casainho/EBike-Smart-Controller/hardware/EBike_Smart_Controller-600x.jpg

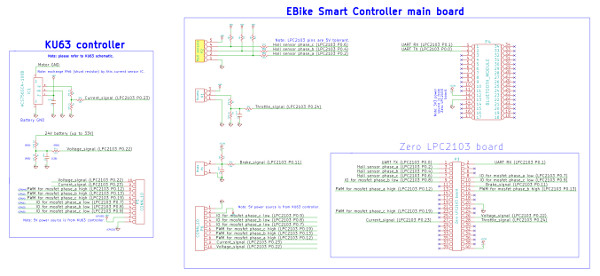
hardware/EBike_Smart_Controller-600x.jpg
