casainho/EBike-Smart-Controller/README.md

EBike-Smart-Controller
======================

EBike Smart Controller
