casainho/EBike-Smart-Controller/hardware/EBike_Smart_Controller-prototype_v2.png

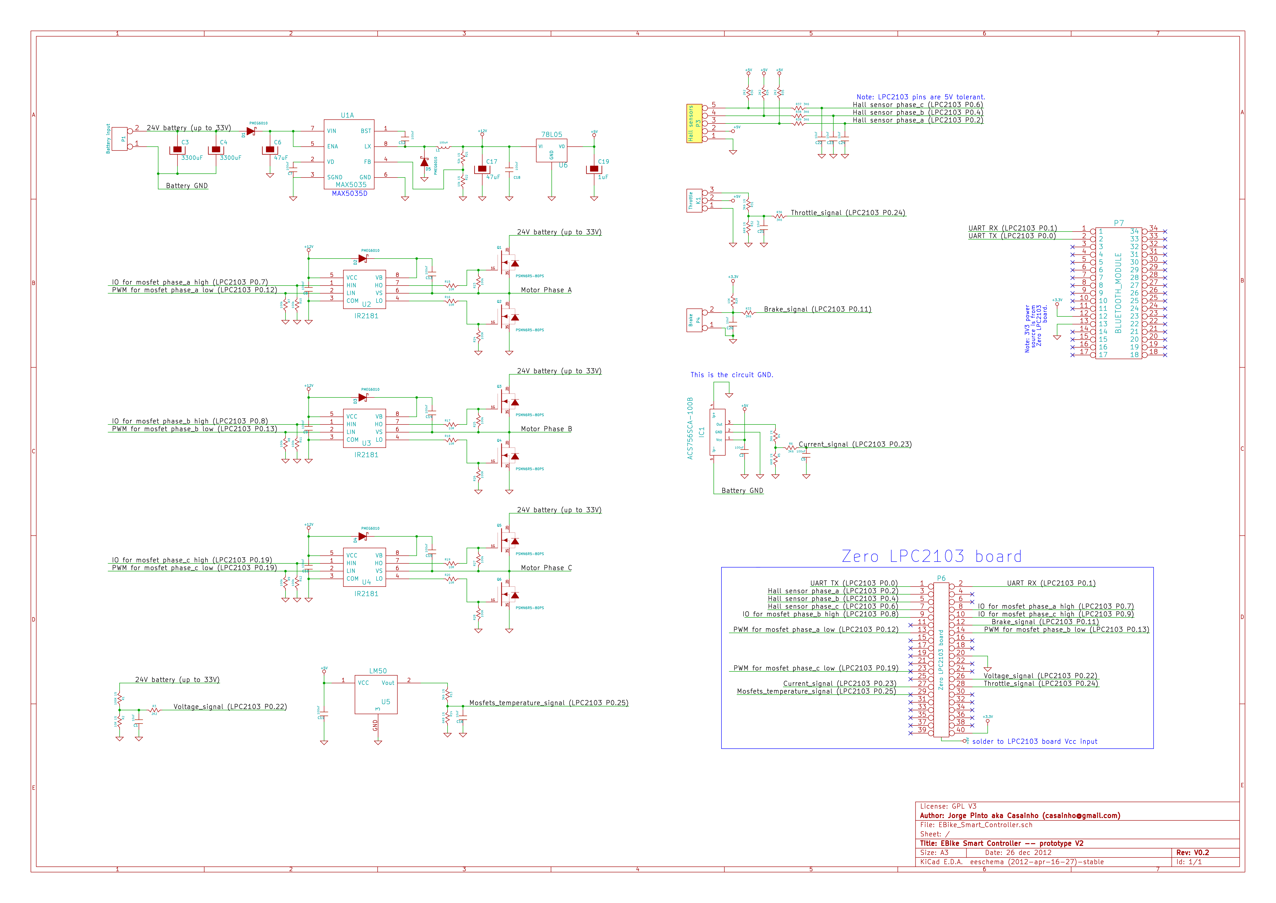
hardware/EBike_Smart_Controller-prototype_v2.png
