casainho/EBike-Smart-Controller/hardware/EBike_Smart_Controller.png

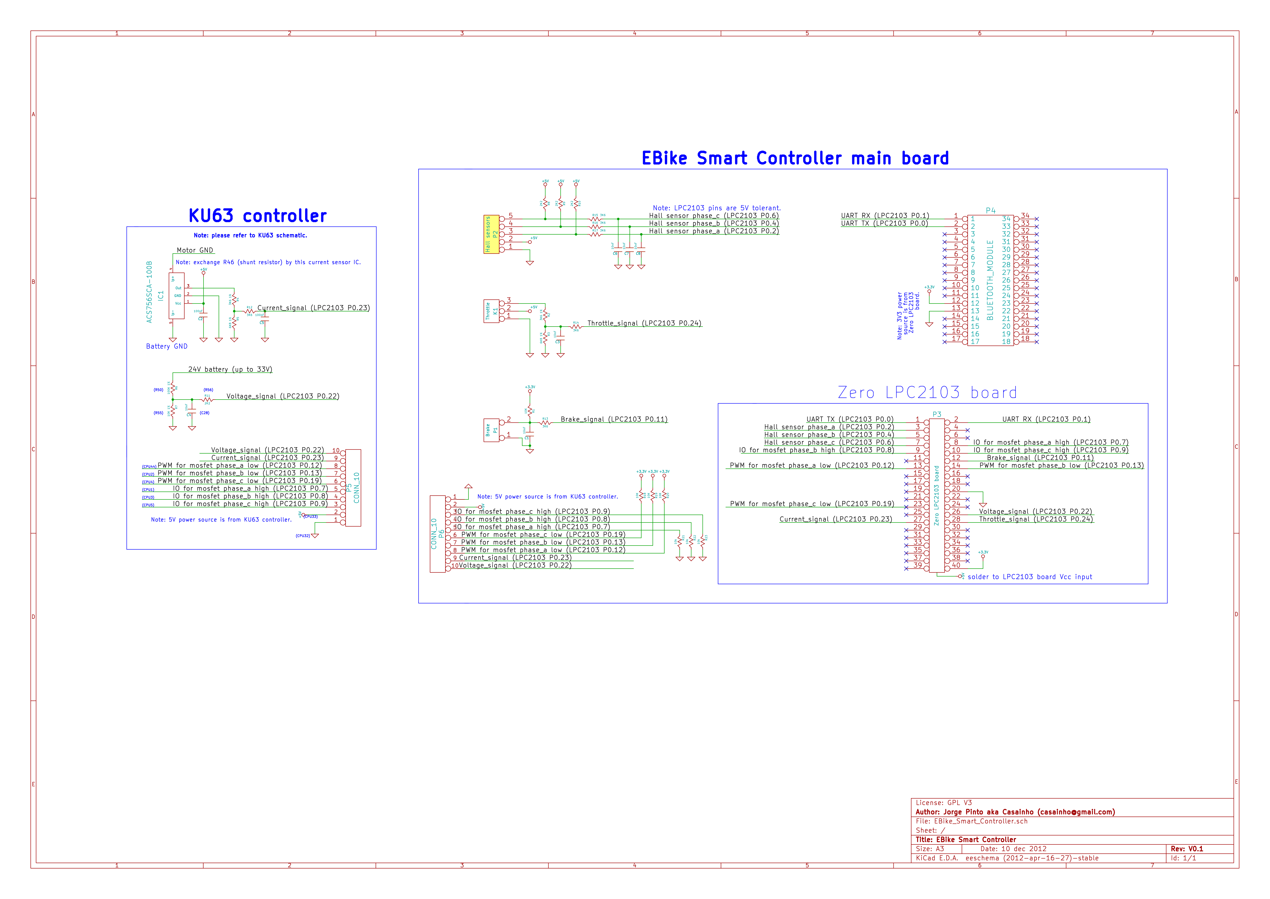
hardware/EBike_Smart_Controller.png
