casainho/EBike-Smart-Controller/hardware/Smart_EBike_Controller.jpg

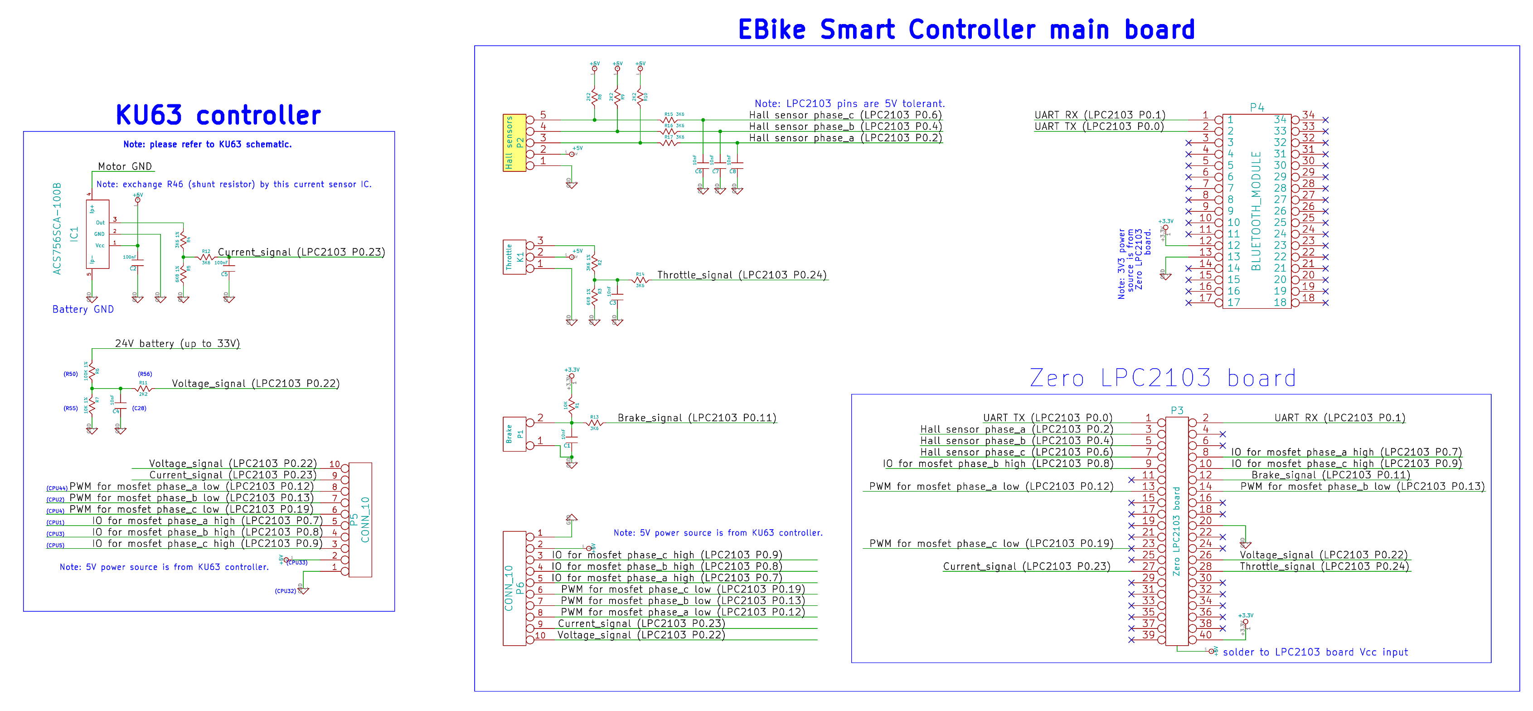
hardware/Smart_EBike_Controller.jpg
