casainho/EBike-Smart-Controller/hardware/EBike_Smart_Controller.sch

## KiCad design hardware/EBike_Smart_Controller.sch (2013-02-16)

Schematic: EBike_Smart_Controller.sch

Parts:
C1, C16, C20, C21, C22, C23, C24: 10nF
C2, C7, C8, C9, C10, C11, C12, C13, C14, C15, C18, C28: 100nF
C3: 10mF
C4, C25, C26, C27: 10uF
C6, C17: 47uF
C19: 1uF
D1, D2, D3, D4, D5: PMEG6010
IC1: ACS756SCA-050B
K1: Throttle
L1: 100uH
P1: Battery input
P2: EXT1
P3: Hall sensors
P4: Brake
P5: EXT2
P7: BLUETOOTH_MODULE
Q1, Q2, Q3, Q4, Q5, Q6: PSMN6R5-80PS
R1: 100K 1%
R2: 10K 1%
R3: 2K2
R4, R13, R31: 3K6 1%
R5, R14, R32, R34, R37, R39: 6K8 1%
R6, R30, R33, R35, R36, R38: 3K6
R7, R8, R9, R10, R11, R12, R23, R25, R27: 100k
R15, R16, R17, R18, R19, R20: 10R
R21: 92k 1%
R22: 10k 1%
R24, R26, R28: 100K
R29: 10K
U1: MAX5035
U2, U3, U4: IR2181
U5: LM50
U6: 78L05
U7: LM358

Notes on the sheet:
This is the circuit GND.
MAX5035D
Note: 3V3 power source is from STM32F100 header board.
STM32F100 (Bravekit.com Header board)
Wire to S1 button on the board
