casainho/EBike-Smart-Controller/firmware/adc.c

/*
 * EBike Smart Controller
 *
 * Copyright (C) Jorge Pinto aka Casainho, 2012, 2013.
 *
 *   casainho [at] gmail [dot] com
 *     www.casainho.net
 *
 * Released under the GPL License, Version 3
 */

#include "stm32f10x_rcc.h"
#include "stm32f10x_gpio.h"
#include "stm32f10x_adc.h"
#include "stm32f10x_dma.h"

static unsigned int adc_values[4] = {0, 0, 0, 0};

void adc_init (void)
{
  /* ADCCLK = PCLK2/8 */
  RCC_ADCCLKConfig(RCC_PCLK2_Div8);

  /* Enable DMA1 clock */
  RCC_AHBPeriphClockCmd(RCC_AHBPeriph_DMA1, ENABLE);

  DMA_InitTypeDef DMA_InitStructure;
  /* DMA1 channel1 configuration ----------------------------------------------*/
  DMA_DeInit(DMA1_Channel1);
  DMA_InitStructure.DMA_PeripheralBaseAddr = (uint32_t) &(ADC1->DR);
  DMA_InitStructure.DMA_MemoryBaseAddr = (uint32_t) &adc_values;
  DMA_InitStructure.DMA_DIR = DMA_DIR_PeripheralSRC;
  DMA_InitStructure.DMA_BufferSize = 4;
  DMA_InitStructure.DMA_PeripheralInc = DMA_PeripheralInc_Disable;
  DMA_InitStructure.DMA_MemoryInc = DMA_MemoryInc_Enable;
  DMA_InitStructure.DMA_PeripheralDataSize = DMA_PeripheralDataSize_HalfWord;
  DMA_InitStructure.DMA_MemoryDataSize = DMA_MemoryDataSize_Word;
  DMA_InitStructure.DMA_Mode = DMA_Mode_Circular;
  DMA_InitStructure.DMA_Priority = DMA_Priority_High;
  DMA_InitStructure.DMA_M2M = DMA_M2M_Disable;
  DMA_Init(DMA1_Channel1, &DMA_InitStructure);

  /* Enable DMA1 channel1 */
  DMA_Cmd(DMA1_Channel1, ENABLE);

  ADC_InitTypeDef ADC_InitStructure;
  /* ADC1 configuration ------------------------------------------------------*/
  ADC_InitStructure.ADC_Mode = ADC_Mode_Independent;
  ADC_InitStructure.ADC_ScanConvMode = ENABLE;
  ADC_InitStructure.ADC_ContinuousConvMode = ENABLE;
  ADC_InitStructure.ADC_ExternalTrigConv = ADC_ExternalTrigConv_None;
  ADC_InitStructure.ADC_DataAlign = ADC_DataAlign_Right;
  ADC_InitStructure.ADC_NbrOfChannel = 4;
  ADC_Init(ADC1, &ADC_InitStructure);

  /* ADC1 regular channel0 configuration */
  ADC_RegularChannelConfig(ADC1, ADC_Channel_0, 1, ADC_SampleTime_55Cycles5);
  /* ADC1 regular channel1 configuration */
  ADC_RegularChannelConfig(ADC1, ADC_Channel_1, 2, ADC_SampleTime_55Cycles5);
  /* ADC1 regular channel2 configuration */
  ADC_RegularChannelConfig(ADC1, ADC_Channel_2, 3, ADC_SampleTime_55Cycles5);
  /* ADC1 regular channel3 configuration */
  ADC_RegularChannelConfig(ADC1, ADC_Channel_3, 4, ADC_SampleTime_55Cycles5);

  /* Enable ADC1 DMA */
  ADC_DMACmd(ADC1, ENABLE);

  /* Enable ADC1 */
  ADC_Cmd(ADC1, ENABLE);

  /* Enable ADC1 reset calibration register */
  ADC_ResetCalibration(ADC1);
  /* Check the end of ADC1 reset calibration register */
  while(ADC_GetResetCalibrationStatus(ADC1));

  /* Start ADC1 calibration */
  ADC_StartCalibration(ADC1);
  /* Check the end of ADC1 calibration */
  while(ADC_GetCalibrationStatus(ADC1));

  /* Start ADC1 Software Conversion */
  ADC_SoftwareStartConvCmd(ADC1, ENABLE);
}

unsigned int adc_get_throttle_value (void)
{
  return adc_values[0];
}

unsigned int adc_get_voltage_value (void)
{
  return adc_values[1];
}

unsigned int adc_get_current_value (void)
{
  return adc_values[2];
}

unsigned int adc_get_temperature_value (void)
{
  return adc_values[3];
}
