casainho/EBike-Smart-Controller/firmware/dac.c

/*
 * EBike Smart Controller
 *
 * Copyright (C) Jorge Pinto aka Casainho, 2012, 2013.
 *
 *   casainho [at] gmail [dot] com
 *     www.casainho.net
 *
 * Released under the GPL License, Version 3
 */

#include "stm32f10x_rcc.h"
#include "stm32f10x_gpio.h"
#include "stm32f10x_tim.h"
#include "stm32f10x_dac.h"

void dac_init (void)
{
  /* DAC channel1 Configuration */
  DAC_InitTypeDef DAC_InitStructure;
  DAC_InitStructure.DAC_Trigger = DAC_Trigger_Software;
  DAC_InitStructure.DAC_WaveGeneration = DAC_WaveGeneration_None;
  DAC_InitStructure.DAC_OutputBuffer = DAC_OutputBuffer_Enable;
  DAC_Init(DAC_Channel_1, &DAC_InitStructure);

  /* Enable DAC Channel1: Once the DAC channel1 is enabled, PA.04 is
     automatically connected to the DAC converter. */
  DAC_Cmd(DAC_Channel_1, ENABLE);

  /* Set DAC Channel1 DHR12L register */
  DAC_SetChannel1Data(DAC_Align_12b_R, 0x7FF0);
}
