casainho/EBike-Smart-Controller/(commit log)

2012-05-07 First firmware code for LPC2103 that switchs the mosfets with PWM signal.
    [lpc2103.cfg, olimex-jtag-tiny.cfg]
2012-05-14 More work on BLDC 6 steps commutation.
2012-08-16 Added connected pin information from LPC2103 and KU63 controller.
2012-08-18 More work for testing current measure with oscilloscope.
2012-08-18 More working on timers. PWM logic is now inverted since I found (just now :-( )hardware inverts the signal!
    [main.c, motor.c, pwm.c]
2012-09-02 delay_us () works using TIMER0.
2012-09-08 Resolved a bug on lpc210x.h for Timer2. Now delay_us() works using Timer2. Timer0 interrupt also works.
    [main.c, pwm.c]
2012-09-09 PWM now works
2012-09-10 simple testing code for sart-up/slow motor rotation
2012-09-10 motor runsgit add main.c motor.c :-)
2012-09-19 Now calling a funtion on interrupt code works, before a Prefetch Data Abort were happen.
2012-10-02 Exchanged Timer0 code to Timer2 since Timer2 will be the one calling the function for mosfets commutation.
2012-10-02 More work on code exchange from Timers.
2012-10-03 Timer2 code works and tested.
2012-10-20 Add the hardware folder with some KiCad schematics.
    [EBike_Smart_Controller.sch]
2012-10-20 Put current firmware on firmware folder
    [lpc2103.cfg, olimex-jtag-tiny.cfg]
2012-10-20 Clean up the root folder.
    [lpc2103.cfg, olimex-jtag-tiny.cfg]
2012-10-21 More work on schematic: added connections to Zero LPC2103 board.
    [EBike_Smart_Controller.sch]
2012-10-21 This may be a final version of the schematic.
    [EBike_Smart_Controller.sch]
2012-10-25 First work on firmware to support the hall sensors (using the latest schematic). Untested code.
2012-10-27 More work on the firmware. Added motor and ADC code. Untested.
2012-10-27 Small updates to schematic.
    [EBike_Smart_Controller.sch]
2012-10-28 Hall sensor pin readings working as expected but not interrupt on pin change (Capture). ADC current reading works but will not work if PWM is enable.
    [adc.c, bldc.c, main.c, motor.c]
2012-10-29 This code makes the motor shake and rotate. Something happens but is far from perfect.
2012-11-01 The code for fiding the rotor position seems to be working only the ADC is not working.
    [bldc.c, bldc.h, config.h, main.c, motor.c]
2012-11-02 ADC voltage and current works. BLDC find rotor positions also works.
2012-11-05 Updated commutation_sector code (back to correct values before hall sensors code). Also updated rotor_find_position_sector().
    [bldc.c, main.c]
2012-11-12 Now current control works. The current sensor needs a capacitor to make a low pass filter so ADC can take the measures.
2012-11-15 Back again to Hall Sensor code. Added Hall Sensor code including current control. Untested code.
2012-11-16 Added capacitor to schematic, for filtering/average the current signal.
    [EBike_Smart_Controller.sch]
2012-11-18 With this code the motor works (but on inverse direction) and it reacts as expected to PWM changes, that also changes the velocity.
2012-11-27 Exchanged the PWM and IOs for mosfets since it was wrong.
    [bldc_hall.c, main.c, pwm.c]
2012-11-28 Changes so Q1/Q3/Q5 take the PWM signal instead Q2/Q4/Q6.
2012-11-28 FINALLY!! motor works!! but sometimes it start-up others don't and I can start it by hand on that times. Need more work to understand the lack of start-up.
2012-11-29 Now throttle works perfectly. The motor still fails to start some times.
    [config.h, main.c, motor.c, throttle.c, throttle.h]
2012-12-02 Motor now starts almost the times. It first start in open-loop.
2012-12-03 Added 10nF capacitors to Hall Sensors line signals. Now the firmware works better!
    [EBike_Smart_Controller.sch]
2012-12-06 Added resistors for pull ups and pull downs.
    [EBike_Smart_Controller.sch]
2012-12-10 Schematic update, for some pull up and pull down resistors.
    [EBike_Smart_Controller.sch]
2012-12-13 Started to working on Prototype V2. Added 12V DC-DC to schematic.
    [EBike_Smart_Controller.sch]
2012-12-14 More work on schematic.
    [EBike_Smart_Controller.sch]
2012-12-15 Final schematic of prototype V2 (untested).
    [EBike_Smart_Controller.sch]
2012-12-17 Updated schematic.
    [EBike_Smart_Controller.sch]
2012-12-18 Minor schematic update.
    [EBike_Smart_Controller.sch]
2012-12-24 Updated timers code to reflect the change from 48MHz to 60MHz clock.
2012-12-24 ADC reading in burts mode is working.
2012-12-26 Motor start up very well and runs almost perfect. This firmware is for prototype V2 hardware.
2012-12-26 Changes to schematic to update with current prototype 2.
    [EBike_Smart_Controller.sch]
2012-12-26 Updates to schematic.
    [EBike_Smart_Controller.sch]
2012-12-29 Update the PWM initialize to reflect the 48 to 60MHz changes. The PWM frequency is now of 20KHz.
2012-12-29 Testing code to see if is better like this the current control.
2012-12-30 Finally current control works well. The ADC read is synchronised with PWM cycle.
2012-12-31 The current should work on interrupt code BUT for some reason the generated code seems to fail, on the compare adc read with max currentgit add adc.c bldc_hall.h main.c makefile motor.c pwm.c pwm.h.
    [adc.c, bldc_hall.h, main.c, motor.c, pwm.c, pwm.h]
2013-01-12 Changes on schematic to add the BIG 10mF capacitor. This is now for prototype 3
    [EBike_Smart_Controller.sch]
2013-01-13 First code of prototype 3 (still with LPc2103). The motor works, but not always it start as it should. Current control seems to work well.
2013-01-15 Deleted the firmware folder to start again, this time for STM32F100. LPC2103 were used on prototype 1 and 2.
    [lpc2103.cfg, olimex-jtag-tiny.cfg]
2013-01-15 This first code for STM32F100 builds but is UNTESTED.
2013-01-16 Added OpenOCD v0.5.0 scritps for STM32F1xx (untested).
    [olimex-jtag-tiny.cfg, stm32f1x.cfg]
2013-01-20 This firmware flashs the LED, using SysTick Handler. Thanks to Martin Thomas working example firmwaregit status
    [stm32f1x.cfg]
2013-01-20 The ADC works for reading throttle signal (ADC pooling mode).
2013-01-20 Now ADC works with DMAgit add Flash\ and\ Debug.launch adc.c main.c The value from ADC throttle signal go to memory variable using DMA.
2013-01-22 Modified schematic for prototype V3 (using the STM32F100 instead LPC2103).
    [EBike_Smart_Controller.sch]
2013-01-24 Now the 4 ADC channels get readed and values placed on memory RAM by DMA :-)
2013-01-24 small changes on schematic
    [EBike_Smart_Controller.sch]
2013-01-27 Now PWM phase_a_high, phase_b_high and phase_c_high works.
    Needs more work on PWM drivers and to put the PWM frequency at 20KHz.
2013-01-28 Throttle works and configures correctly the duty cycle. PWM works almost perfect at 20KHz. Commutation seems to works well BUT is forced right now, the hall sensors code is not done yet.
    [bldc_hall.c, bldc_hall.h, config.h, main.c, pwm.c, throttle.c, throttle.h]
2013-02-03 Updated the linkerscript reflecting the correct 16K flash memory of STM32F100.
2013-02-03 Hall sensors GPIO input signal works. The interrupt for Hall Sensors doesn't work.
    [bldc_hall.c, gpio.c, gpio.h, main.c, throttle.h]
2013-02-04 Now Hall Sensors are working as expected!
2013-02-08 First DAC code working (testing code that outputs a triangle wave on DAC1 pin). This is the first work for having current control.
2013-02-08 Now motor_set_max_current() works - it outputs the correct voltage on DAC.
    [bldc.c, bldc.h, config.h, dac.c, main.c]
2013-02-09 Cruise control works. Added code for brake and current control and it may make the PWM code stop working on some channels.
2013-02-09 The motor runs as expected! Cruise control works very well.
2013-02-09 Schematic changes to reflect the brake and current control.
    [EBike_Smart_Controller.sch]
2013-02-12 PWM correction to avoid use "inverted" value. PWM now works perfectly.
    [gpio.c, hall_sensor.c, main.c, pwm.c]
2013-02-12 Now PWM is correct including the BLDC code.
    [bldc.c, main.c, pwm.c]
2013-02-12 Finally brakes are working.
2013-02-12 Now brakes work including the interrupt for reset the Cruise Control.
    [adc.c, bldc.c, dac.c, gpio.c, hall_sensor.c, main.c, pwm.c]
2013-02-13 More work on motor.c
2013-02-16 Current control now works.
2013-02-16 Updated the current control circuit. Current circuit is working well.
    [EBike_Smart_Controller.sch]
2013-02-18 Tested the max current control and it works as expected.
2013-02-19 First test for printf that builds BUT needs 21k of flash memory. NOT tested.
2013-02-19 Revert "First test for printf that builds BUT needs 21k of flash memory. NOT tested."
    This reverts commit 7c2744ae532e81598bf4c0e1a318dbfec817c790.
    [main.c]
2013-02-20 Added first working code for UART. It works but for now just send some bytes in polling mode.
2013-02-20 Small rectification on Systick config for 10ms instead 1ms interrupt.
2013-02-24 First working code for UART that communicates correctly with Bluetooth module. Also the sersendf.c and sermsg.c code as as "small" printf.
    [main.c, sermsg.c, sermsg.h, sersendf.c, sersendf.h, uart.c, uart.h]
2013-03-10 Initial code for Bluetooth/UART packet communications.
2013-03-29 Changed to STM32F100 with 128kbytes flash memory.
