casainho/EBike-Smart-Controller/(notices)

Notices in the files:
hardware/EBike_Smart_Controller.sch:
License: GPL V3
